Netfreak25/TB2-Dev-Board/docs/Mechanical-requirements.pdf

## J1 - installed land pattern - TOP VIEW

Millimetres; origin at component centre. Coordinate tables define pad centres.

Pin | X | Y(up) | pad W x H
1 | -1.270 | 3.810 1.90 x 1.90
2 | 1.270 | 3.810 1.90 x 1.90
3 | -1.270 | 1.270 1.90 x 1.90
4 | 1.270 | 1.270 1.90 x 1.90
5 | -1.270 -1.270 1.90 x 1.90
6 | 1.270 -1.270 1.90 x 1.90
7 | -1.270 -3.810 1.90 x 1.90
8 | 1.270 -3.810 1.90 x 1.90

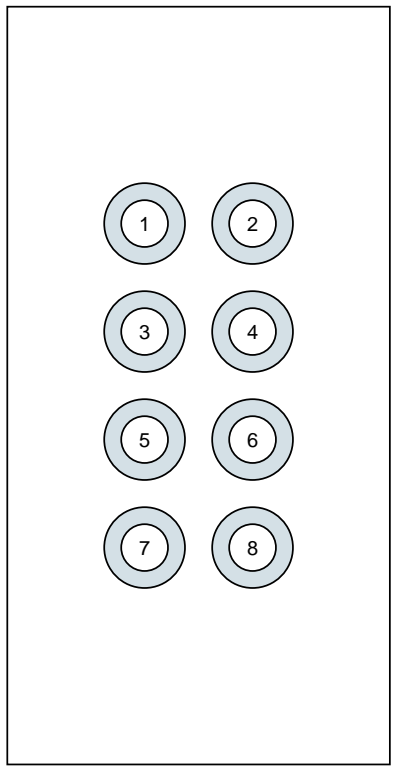
[picture p3: figure]

Straight MALE 2x4 shrouded IDC; 2.54 mm pitch and row spacing.
Notch LEFT; contact 1 upper-left. Physical numbering 1,3,5,7 LEFT; 2,4,6,8 RIGHT.
Reference envelope 9.00 x 17.82 mm; finished holes 1.10 mm; square pins 0.64 mm.
Propose economical equivalent with complete keyed cavity/pin-1 drawing and solder-process rating. Reference: Wuerth 61200821621. No substitute is qualified by pitch alone.

## D1 - installed land pattern - TOP VIEW

Millimetres; origin at component centre. Coordinate tables define pad centres.

2 (A) | 1 (K)
Pin | X | Y(up) | pad W x H
2 (A) | -0.825 | 0.000 0.80 x 0.80
1 (K) | 0.825 | 0.000 0.80 x 0.80

POWER yellow-green, 565-575 nm. Anode LEFT; cathode RIGHT.
0603 / 1608 body; pads 0.80 x 0.80 mm; pad centre spacing 1.65 mm.
Vf <=2.2 V at 1 mA. Show suitability/brightness at 0.5-1 mA.
Supplier must identify exact MPN and demonstrate polarity/land-pattern compatibility.

## D2 - installed land pattern - TOP VIEW

Millimetres; origin at component centre. Coordinate tables define pad centres.

2 (A) | 1 (K)
Pin | X | Y(up) | pad W x H
2 (A) | -0.825 | 0.000 0.80 x 0.80
1 (K) | 0.825 | 0.000 0.80 x 0.80

ACCESS red, 620-635 nm. Anode LEFT; cathode RIGHT.
0603 / 1608 body; pads 0.80 x 0.80 mm; pad centre spacing 1.65 mm.
Vf <=2.2 V at 1 mA. Show suitability/brightness at 0.5-1 mA.
Supplier must identify exact MPN and demonstrate polarity/land-pattern compatibility.

## S1 - installed land pattern - TOP VIEW

Millimetres; origin at component centre. Coordinate tables define pad centres.

ON | COM | OFF_unused
housing1 | housing2
housing3 | housing4
Pin | X | Y(up) | pad W x H
COM | -0.750 -2.075 0.75 x 1.25
ON | -2.250 -2.075 0.75 x 1.25

OFF_unused 2.250 -2.075 0.75 x 1.25

housing1 | -3.800 | 1.100 0.90 x 0.90
housing2 | 3.800 | 1.100 0.90 x 0.90
housing3 | -3.800 -1.100 0.90 x 0.90
housing4 | 3.800 -1.100 0.90 x 0.90

Fixed MPN Hroparts K3-1296S-E1. Actuator points UP.
Two NPTH locating holes: diameter 0.90 mm; centres (-1.50,0) and (+1.50,0).
COM connects to 3V3_IN; ON to POWER_SWITCHED; OFF pad electrically unused. All four metal housing tabs are soldered to GND.

## S2 - installed land pattern - TOP VIEW

Millimetres; origin at component centre. Coordinate tables define pad centres.

1 | 2
3 | 4
Pin | X | Y(up) | pad W x H
1 | -2.075 | 1.075 1.05 x 0.65
2 | 2.075 | 1.075 1.05 x 0.65
3 | -2.075 -1.075 1.05 x 0.65
4 | 2.075 -1.075 1.05 x 0.65

Fixed MPN ALPS SKRPACE010. Momentary normally open; gate circuit only. Physical 1-2 internally common; physical 3-4 internally common.
Logical Fritzing IDs are not the physical manufacturer numbering.
