Netfreak25/TB2-Dev-Board/assets/back-silkscreen.png

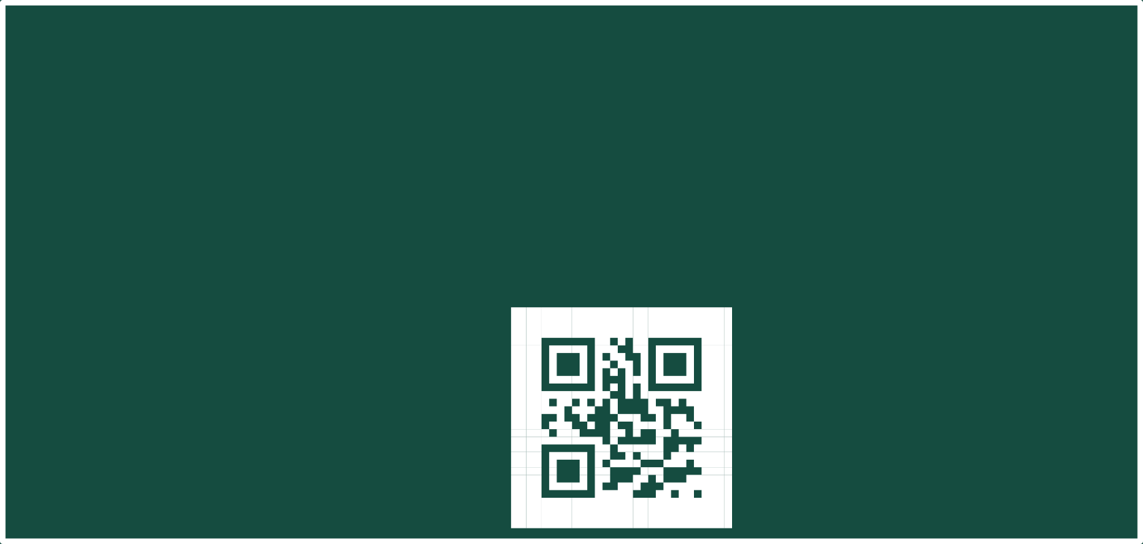
assets/back-silkscreen.png
