Netfreak25/TB2-Dev-Board/manufacturing/pcbway/BOM.csv

Designator | Quantity_per_board | Quantity_for_5_boards | Selection | Manufacturer | MPN | Package | Side | Required_specification | Reference_MPN | Qualification | Document_status
JZ1 | 1 | 5 | FIXED_REPLACE | XFCN | PZ254V-11-07P | THT 1x7 2.54mm | Bottom | Flipper 2-8; 0.64mm square pins; mating length 6.1+/-0.2mm; insulator 2.5mm; tail 3.0+/-0.2mm; long pins point down | 61300711121 | New physical fit not tested; Flipper 6-8 isolated on PCB | MINI PROTOTYPE RFQ; supplier part review before production
JZ2 | 1 | 5 | FIXED_REPLACE | XFCN | PZ254V-11-03P | THT 1x3 2.54mm | Bottom | Flipper 9-11; same pin geometry as JZ1; long pins point down | 61300911121 | Remove only Flipper 12-17; Flipper 10 isolated on PCB | MINI PROTOTYPE RFQ; supplier part review before production
J1 | 1 | 5 | PROPOSE_MECHANICAL |  |  | THT 2x4 shrouded 2.54mm | Top | Straight male keyed IDC box header; pitch and row spacing 2.54mm; square 0.64mm contacts; >=1A; existing cable compatible; provide outline/cavity/notch/pin1/hole drawing; lead-free THT process compatibility required; installed envelope <=9.0mm across x <=17.82mm along rows; finished PCB drills 1.1mm; notch LEFT and contact 1 upper-left in TOP view; see Mechanical-requirements.pdf and physical pad coordinates | Wuerth 61200821621; BOOMELE C9135 is conditional price reference | Specific part and drawing must be qualified before layout freeze; C9135 processing limit 220C/10s is not blanket lead-free approval; original Wuerth fallback | MINI PROTOTYPE RFQ; supplier part review before production
U1 | 1 | 5 | FIXED_REPLACE | Texas Instruments | SN74LVC1G123DCTR | TI DCT-8 0.65mm | Top | Exact retriggerable monostable and manufacturer required; retain existing RC network | SN74LVC1G123DCUR | New DCT footprint; existing DCU footprint cannot be reused | MINI PROTOTYPE RFQ; supplier part review before production
U2 | 1 | 5 | FIXED_KEEP | Texas Instruments | SN74LVC1G132DCKR | TI DCK-5 SC70 | Top | Exact Schmitt-trigger NAND; oscillator operation must remain unchanged |  |  | MINI PROTOTYPE RFQ; supplier part review before production
Q1 | 1 | 5 | FIXED_KEEP | Alpha & Omega Semiconductor | AO3401A | SOT-23 | Top | P-channel MOSFET; G1 S2 D3; original AOS device | AO3401A | Other manufacturers using same short part number are not automatically equivalent | MINI PROTOTYPE RFQ; supplier part review before production
S1 | 1 | 5 | FIXED_REPLACE | Hroparts | K3-1296S-E1 | SMD 6.6x2.7mm | Top | Latching SPDT slide switch; right-angle actuation; exact contact drawing and locating posts required; catalog 300mA 4V | JS102011CQN | Exact DC switching rating and target-board load/inrush must be checked before production; do not infer COM from physical middle pin | MINI PROTOTYPE RFQ; supplier part review before production
S2 | 1 | 5 | FIXED_REPLACE | ALPS Alpine | SKRPACE010 | SMD 4.2x3.2x2.5mm | Top | Momentary SPST-NO; gate circuit only; minimum load 10uA/1V; 2.55N; documented contact pairs | KMR223NGULCLFG | New footprint; existing gate resistors remain 100k and 1k | MINI PROTOTYPE RFQ; supplier part review before production
R1,R2,R9 | 3 | 15 | SPEC_SELECT |  |  | 0603 | Top | 1k ohm; 0603 imperial (1608 metric); 1%; >=0.1W; >=50V working voltage; TCR <=100ppm/K absolute; thick film; lead-free compatible; RoHS; cheapest compliant Chinese manufacturer preferred | RC0603FR-071KL | One shared MPN for each reference group; state selected manufacturer and MPN in quote | MINI PROTOTYPE RFQ; supplier part review before production
R5 | 1 | 5 | SPEC_SELECT |  |  | 0603 | Top | 10k ohm; 0603 imperial (1608 metric); 1%; >=0.1W; >=50V working voltage; TCR <=100ppm/K absolute; thick film; lead-free compatible; RoHS; cheapest compliant Chinese manufacturer preferred | RC0603FR-0710KL | One shared MPN for each reference group; state selected manufacturer and MPN in quote | MINI PROTOTYPE RFQ; supplier part review before production
R6,R8 | 2 | 10 | SPEC_SELECT |  |  | 0603 | Top | 100k ohm; 0603 imperial (1608 metric); 1%; >=0.1W; >=50V working voltage; TCR <=100ppm/K absolute; thick film; lead-free compatible; RoHS; cheapest compliant Chinese manufacturer preferred | RC0603FR-07100KL | One shared MPN for each reference group; state selected manufacturer and MPN in quote | MINI PROTOTYPE RFQ; supplier part review before production
R7 | 1 | 5 | SPEC_SELECT |  |  | 0603 | Top | 560k ohm; 0603 imperial (1608 metric); 1%; >=0.1W; >=50V working voltage; TCR <=100ppm/K absolute; thick film; lead-free compatible; RoHS; cheapest compliant Chinese manufacturer preferred | RC0603FR-07560KL | One shared MPN for each reference group; state selected manufacturer and MPN in quote | MINI PROTOTYPE RFQ; supplier part review before production
R10 | 1 | 5 | SPEC_SELECT |  |  | 0603 | Top | 4.7k ohm; 0603 imperial (1608 metric); 1%; >=0.1W; >=50V working voltage; TCR <=100ppm/K absolute; thick film; lead-free compatible; RoHS; cheapest compliant Chinese manufacturer preferred | RC0603FR-074K7L | One shared MPN for each reference group; state selected manufacturer and MPN in quote | MINI PROTOTYPE RFQ; supplier part review before production
C1,C4 | 2 | 10 | SPEC_SELECT |  |  | 0603 | Top | 100nF; X7R; 10%; >=16V; MLCC; 3.3V decoupling; lead-free compatible; RoHS; cheapest compliant Chinese manufacturer preferred | GRM188R71C104KA01D | State manufacturer and MPN; one shared part for both references | MINI PROTOTYPE RFQ; supplier part review before production
C2,C3 | 2 | 10 | SPEC_DC_BIAS_REVIEW |  |  | 0805 | Top | 1uF; X7R; 10%; >=10V; MLCC; no reduction to 0603; no Y5V/Z5U; lead-free compatible; RoHS; cheapest compliant Chinese manufacturer preferred | GRM21BR71A105KA01L | Provide exact MPN and DC-bias curve for comparison at 3.3V against reference timing capacitor before qualification; one shared part for both references | MINI PROTOTYPE RFQ; supplier part review before production
D1 | 1 | 5 | PROPOSE_LED |  |  | 0603 | Top | Yellow-green dominant wavelength approx 565-575nm; 0603 imperial (1608 metric); top emitting; Vf max 2.2V at 1mA; provide Vf and brightness curves/data around 0.5-1mA; exact polarity and land pattern required; lead-free compatible; RoHS; cheapest suitable Chinese part preferred; actual PCB pads 0.80x0.80mm, centres 1.65mm apart; anode LEFT, cathode RIGHT in TOP view; confirm fit/polarity before supply | 19-213SYGC/S530-E2/5T | Operates from 3.3V via 1k with 4.7k parallel shunt; actual low-current brightness to be checked; reference MPN not mandatory | MINI PROTOTYPE RFQ; supplier part review before production
D2 | 1 | 5 | PROPOSE_LED |  |  | 0603 | Top | Red dominant wavelength approx 620-635nm; 0603 imperial (1608 metric); top emitting; Vf max 2.2V at 1mA; provide Vf and brightness curves/data around 0.5-1mA; exact polarity and land pattern required; lead-free compatible; RoHS; cheapest suitable Chinese part preferred; actual PCB pads 0.80x0.80mm, centres 1.65mm apart; anode LEFT, cathode RIGHT in TOP view; confirm fit/polarity before supply | 19-213SURC/S530-A3/5T | Operates from 3.3V via 1k to U2 output; preserve access blinking; reference MPN not mandatory | MINI PROTOTYPE RFQ; supplier part review before production
