Netfreak25/TB2-Dev-Board/enclosure/TB2_Dev_Board_Case_base.stl

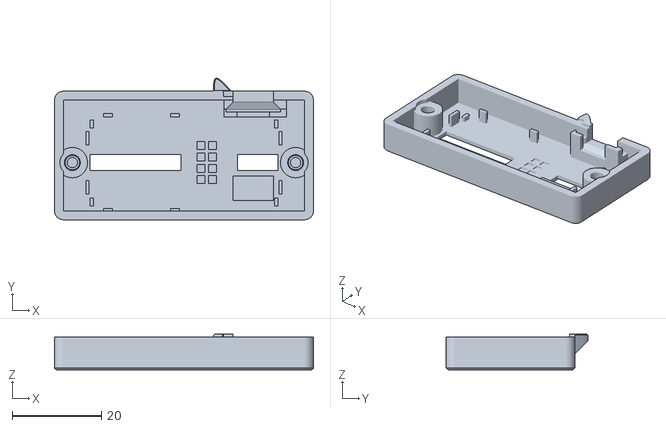
[picture p5: CAD file, 2026-10-14]
enclosure/TB2_Dev_Board_Case_base.stl
58.0 x 31.7 x 8.00
