Netfreak25/TB2-Dev-Board/enclosure/TB2_Dev_Board_Case_reset_brim.stl

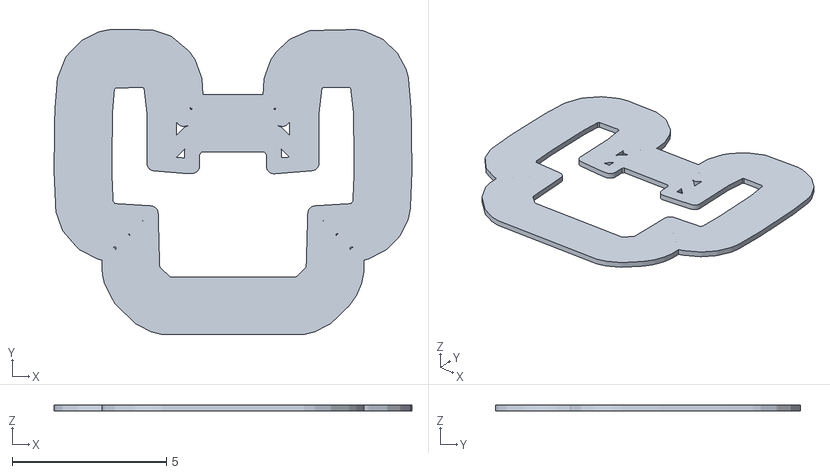
[picture p6: CAD file, 2026-10-14]
enclosure/TB2_Dev_Board_Case_reset_brim.stl
11.6 x 9.89 x 0.2
