Netfreak25/TB2-Dev-Board/enclosure/TB2_Dev_Board_Case_power_slider.stl

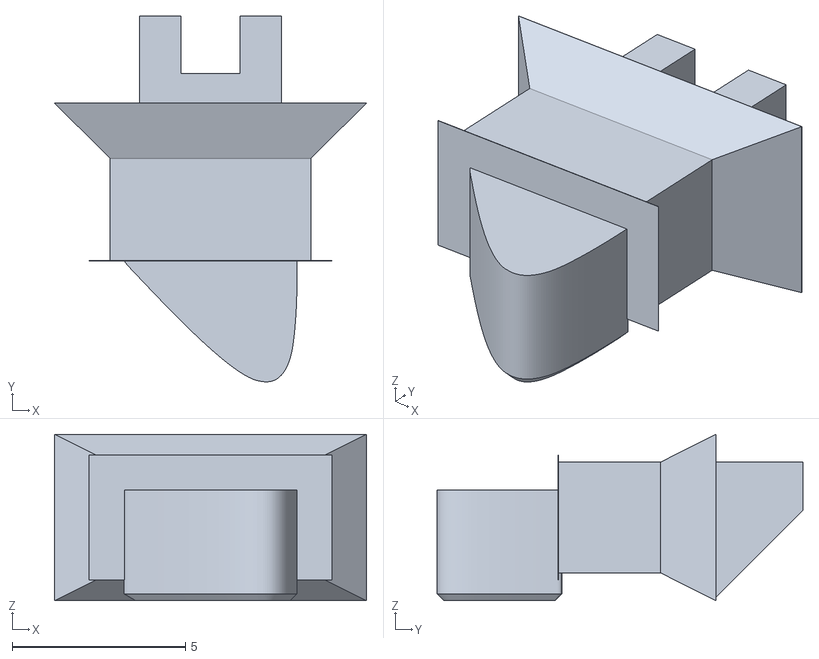
[picture p7: CAD file, 2026-10-14]
enclosure/TB2_Dev_Board_Case_power_slider.stl
9.00 x 10.6 x 4.80
