Netfreak25/TB2-Dev-Board/enclosure/TB2_Dev_Board_Case_reset_button.stl

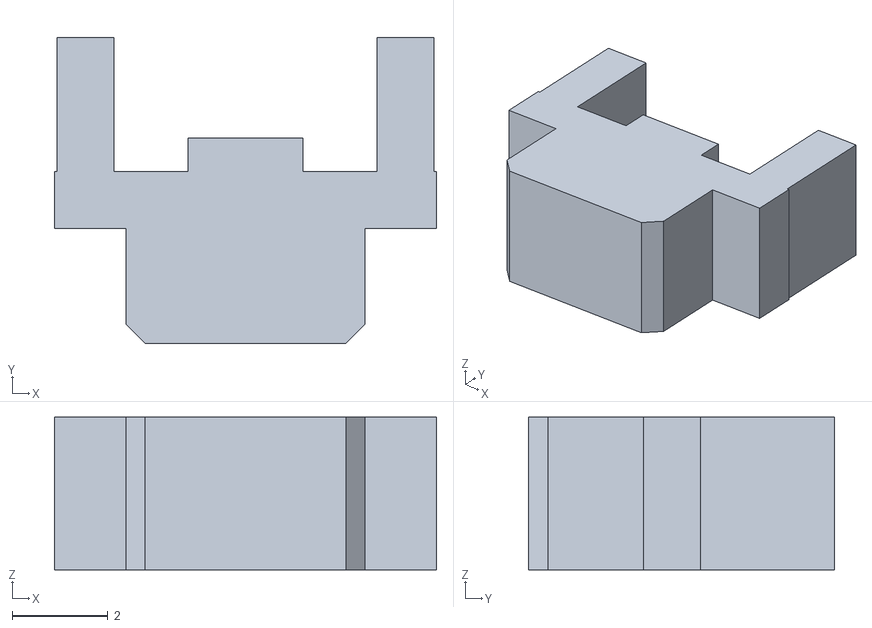
[picture p8: CAD file, 2026-10-14]
enclosure/TB2_Dev_Board_Case_reset_button.stl
8.00 x 6.40 x 3.20
