Netfreak25/TB2-Dev-Board/enclosure/TB2_Dev_Board_Case.3mf

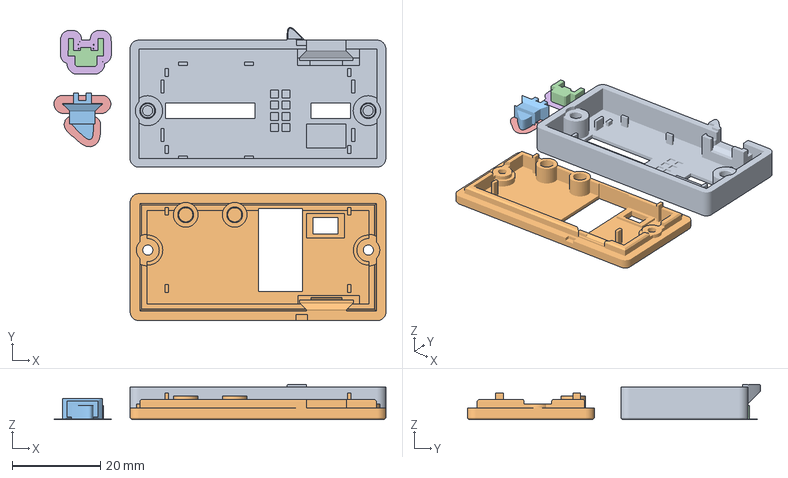
[picture p9: CAD file, 2026-10-14]
enclosure/TB2_Dev_Board_Case.3mf
75.3 x 66.5 x 8.00 mm
Unterteil
Deckel - Weiss, durchgehende erste Schicht
POWER-Schieber
RESET-Knopf
Brim POWER - Orange
Brim RESET - Orange
