Netfreak25/TB2-Dev-Board/enclosure/TB2_Dev_Board_Case_power_brim.stl

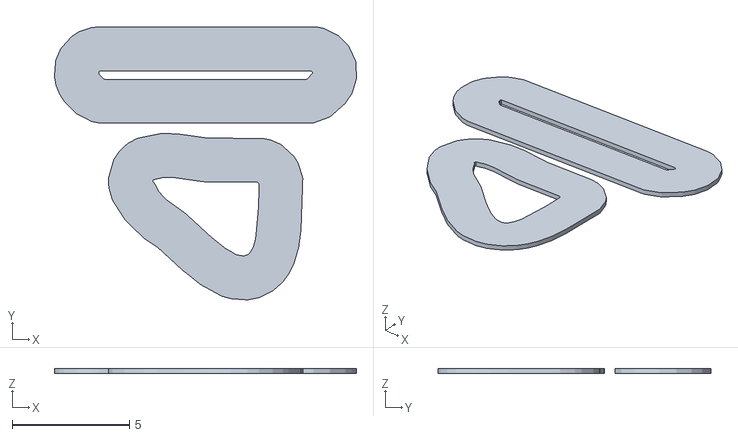
[picture p10: CAD file, 2026-10-14]
enclosure/TB2_Dev_Board_Case_power_brim.stl
12.9 x 11.6 x 0.2
