Netfreak25/TB2-Dev-Board/enclosure/TB2_Dev_Board_Case_lid.stl

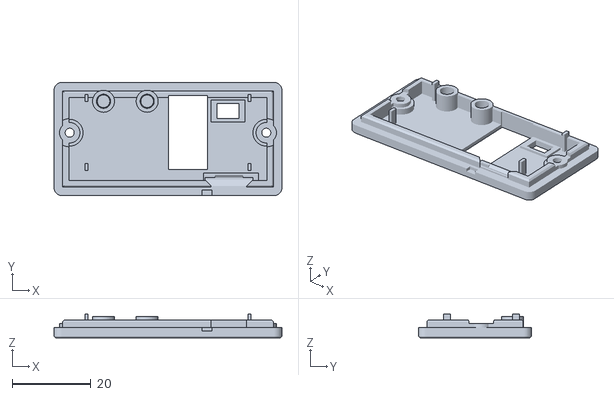
[picture p11: CAD file, 2026-10-14]
enclosure/TB2_Dev_Board_Case_lid.stl
58.0 x 28.8 x 6.05
