Netfreak25/TB2-Dev-Board/(list of files, cad)

Other CAD files:
enclosure/TB2_Dev_Board_Case_print_layout.stl
