Netfreak25/TB2-Dev-Board/docs/Assembly.pdf

# FLIPPER / TB2 DEV - MINI - TOP ASSEMBLY

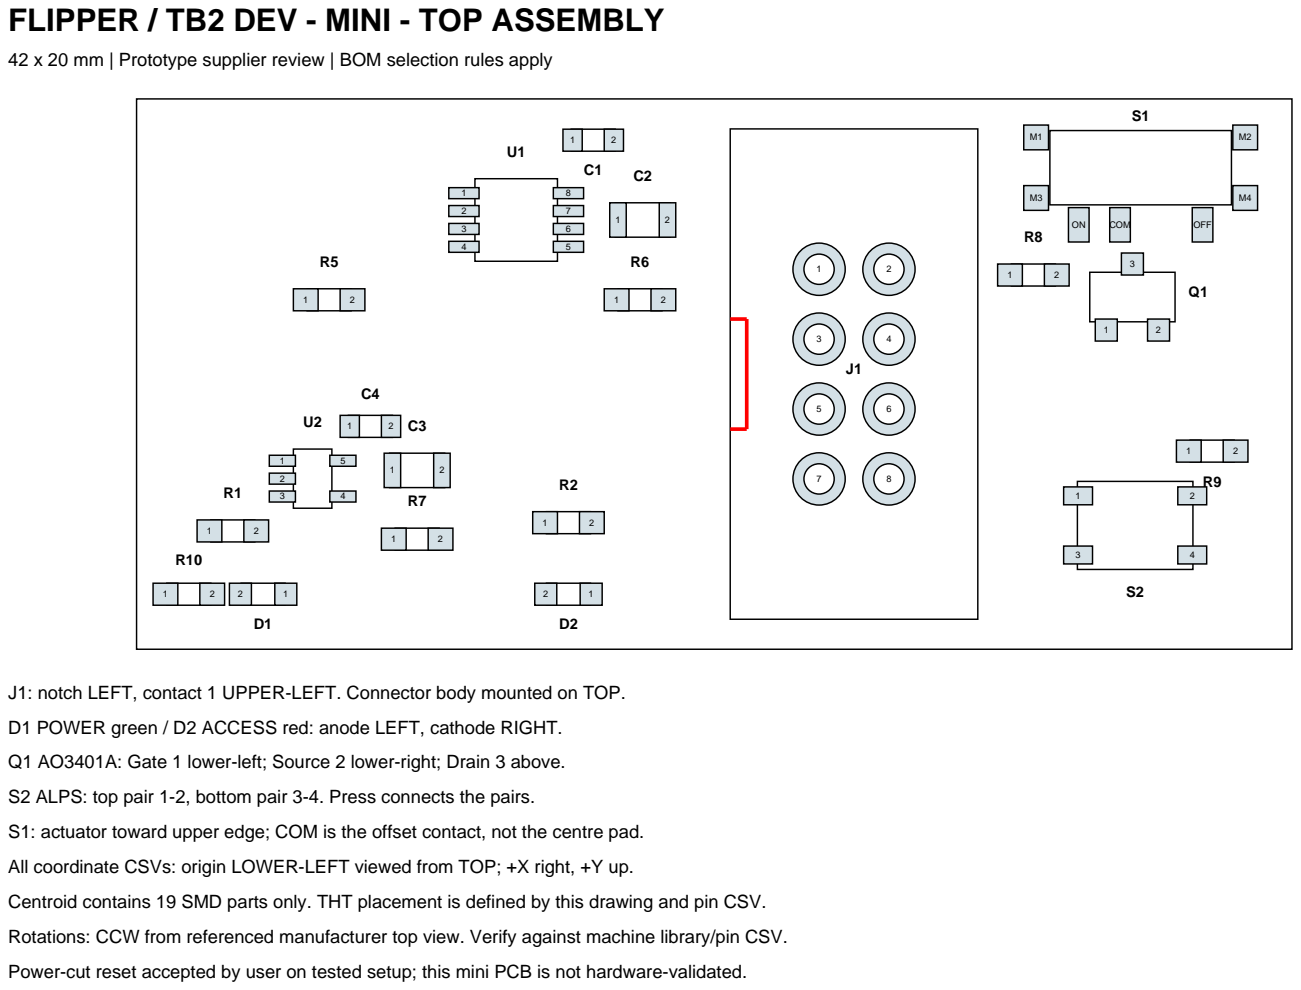
[picture p12: page 1]

42 x 20 mm | Prototype supplier review | BOM selection rules apply

J1: notch LEFT, contact 1 UPPER-LEFT. Connector body mounted on TOP.
D1 POWER green / D2 ACCESS red: anode LEFT, cathode RIGHT.
Q1 AO3401A: Gate 1 lower-left; Source 2 lower-right; Drain 3 above.
S2 ALPS: top pair 1-2, bottom pair 3-4. Press connects the pairs.
S1: actuator toward upper edge; COM is the offset contact, not the centre pad.
All coordinate CSVs: origin LOWER-LEFT viewed from TOP; +X right, +Y up.
Centroid contains 19 SMD parts only. THT placement is defined by this drawing and pin CSV.
Rotations: CCW from referenced manufacturer top view. Verify against machine library/pin CSV.
Power-cut reset accepted by user on tested setup; this mini PCB is not hardware-validated.

# FLIPPER / TB2 DEV - MINI - BOTTOM ASSEMBLY

42 x 20 mm | Prototype supplier review | BOM selection rules apply

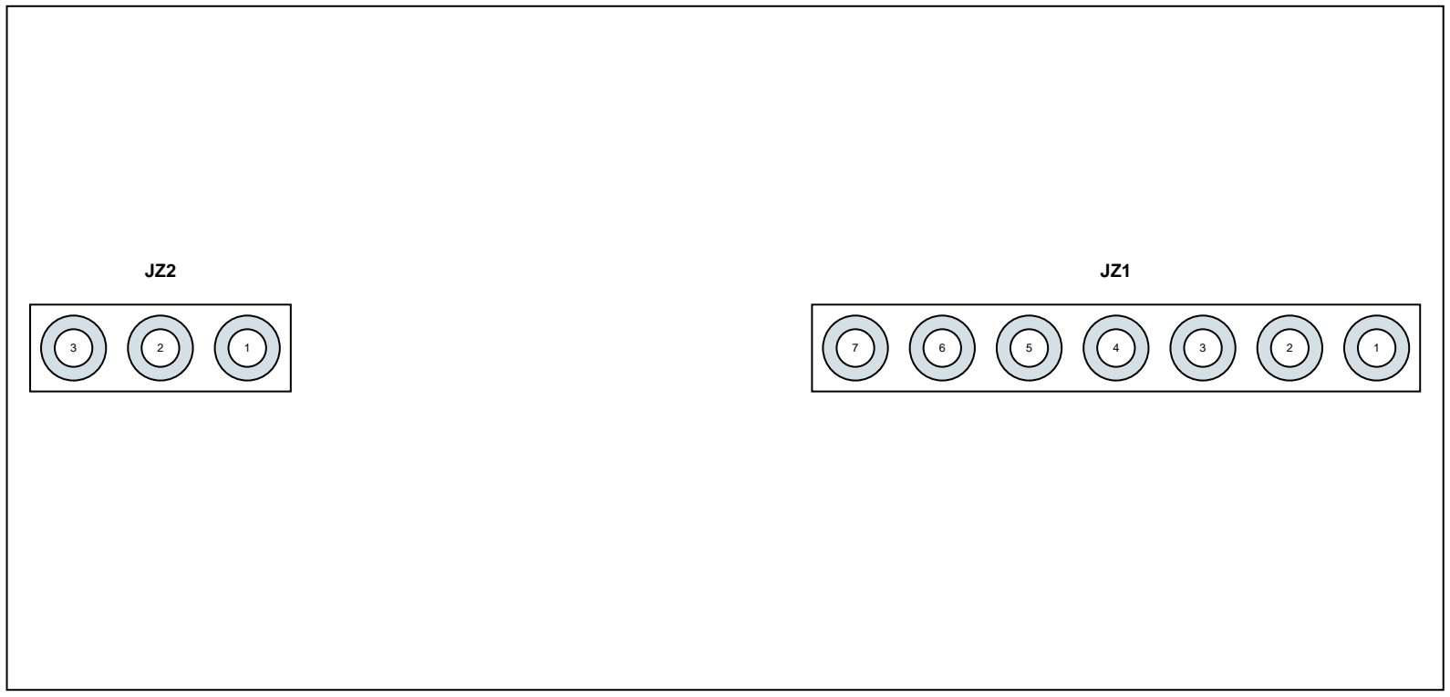
[picture p13: figure]

BOTTOM VIEW IS MIRRORED. JZ1 and JZ2 plastic bodies are BELOW the PCB. Long mating pins: 6.1 +/-0.2 mm DOWN toward Flipper; solder tails 3.0 +/-0.2 mm UP. Board thickness 1.6 mm. Header pitch 2.54 mm. Inner-contact separation 17.78 mm. JZ1 = Flipper 2-8; JZ2 = Flipper 9-11. Do not fit Flipper 1 (5 V).
Do not place supplier markings over the Netfreak QR, pin labels or FRONT arrow.
All coordinate CSVs: origin LOWER-LEFT viewed from TOP; +X right, +Y up.
Centroid contains 19 SMD parts only. THT placement is defined by this drawing and pin CSV. Rotations: CCW from referenced manufacturer top view. Verify against machine library/pin CSV. Power-cut reset accepted by user on tested setup; this mini PCB is not hardware-validated.
