Netfreak25/TB2-Dev-Board/(list of files, drawings)

Other design files:
hardware/TB2-Dev-Board-Rev1.0.fzz
