Netfreak25/TB2-Dev-Board/CHANGELOG.md

# Changelog

## v1.0.1 - Hardware Rev. 1.0

- Published the documentation in English with host-neutral release links.
- Documented SPI Mem Manager, Core Flasher, and TB2 Manager compatibility.
- Removed non-design metadata from the editable Fritzing package.
- Updated the assembly archive naming and release checksums.

The electrical design, Gerber data, BOM, and centroid data are unchanged. The physical mini-board remains an **unverified build candidate**.
