Netfreak25/TB2-Dev-Board/(commit log)

2026-10-08 Publish TB2 Dev Board Rev. 1.0
    [BOM.csv, Centroid.csv, Physical-pin-coordinates.csv, TB2-Dev-Board-Rev1.0.fzz]
2026-10-14 Add logo-free 3D-printable enclosure
    [TB2_Dev_Board_Case.3mf, TB2_Dev_Board_Case.scad, TB2_Dev_Board_Case_base.stl, TB2_Dev_Board_Case_lid.stl, TB2_Dev_Board_Case_power_brim.stl, TB2_Dev_Board_Case_power_slider.stl, TB2_Dev_Board_Case_print_layout.stl, TB2_Dev_Board_Case_reset_brim.stl]
2026-10-14 Add orange enclosure exploded preview
